Ranthalion/rfidLock/README.rst

rfidLock
--------
RFID Lock system

Lamp Server
-----------
Primary Network IP: 10.200.200.11 up on eth0   
Secure Network IP: 172.12.123.20 up on eth1   
Software: Apache2, php5 w/all mods, mariaDB, phpMyAdmin   
Services: SSHD   

Diagram
-------
