Ranthalion/rfidLock/esp8266/control/esp8266RFIDcontrol.kicad_pcb

## KiCad design esp8266/control/esp8266RFIDcontrol.kicad_pcb (2018-11-22)

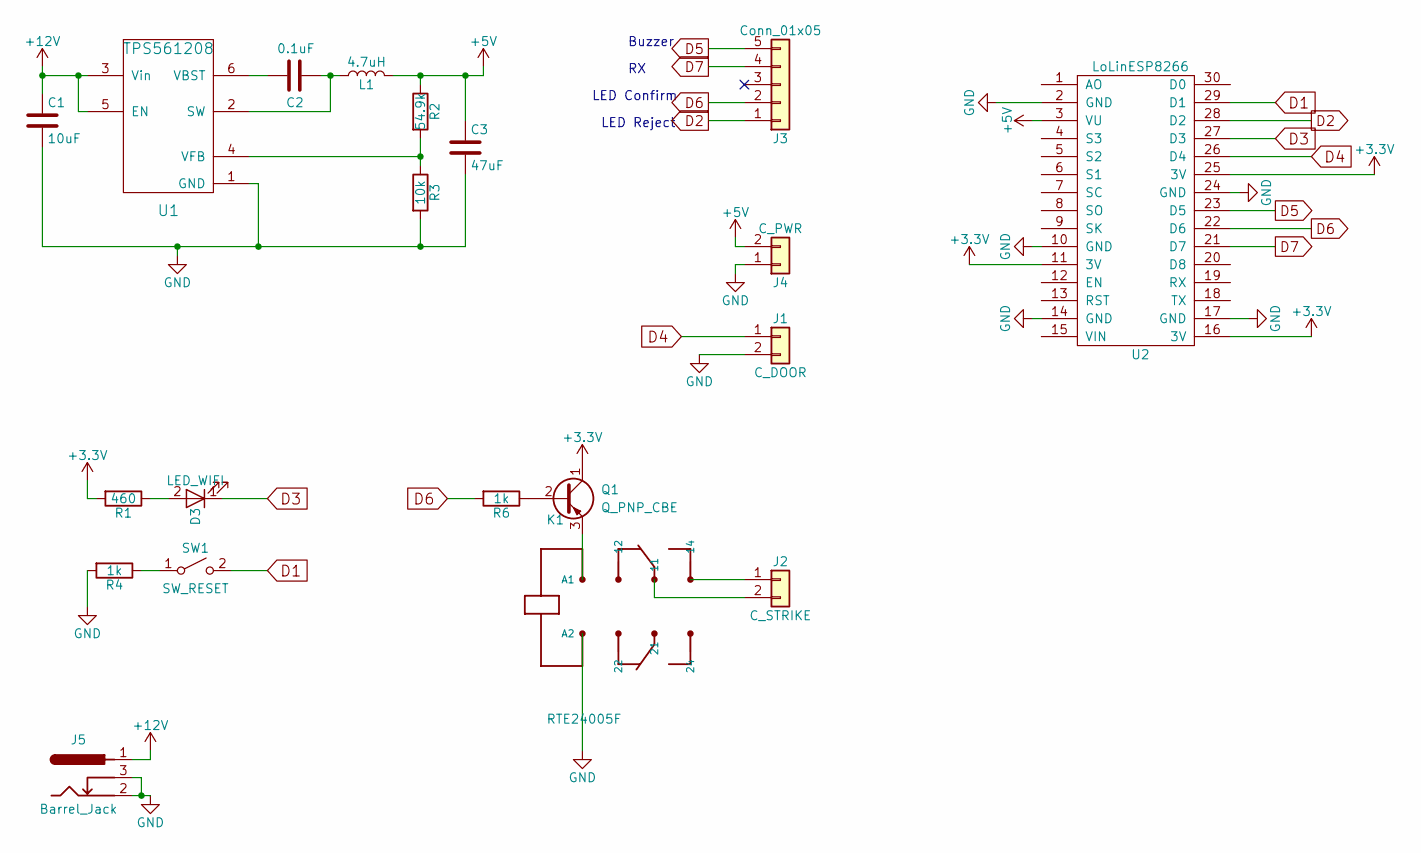
[picture p2: schematic esp8266RFIDcontrol.sch]

Parts:
C1: 10uF; C_1210_HandSoldering
C2: 0.1uF; C_1206_HandSoldering
C3: 47uF; C_1210_HandSoldering
D3: LED_WIFI; LED_0603_HandSoldering
J1: C_DOOR; CONNECTOR_JST_SH_2
J2: C_STRIKE; TerminalBlock_bornier-2_P5.08mm
J3: Conn_01x05; CONNECTOR_JST_SH_5
J4: C_PWR; CONNECTOR_JST_SH_2
J5: Barrel_Jack; BARREL_JACK
K1: RTE24005F
L1: 4.7uH; L_Wuerth_HCI-5040
Q1: Q_PNP_CBE; SOT-23_Handsoldering
R1: 460; R_0805_HandSoldering
R2: 54.9k; R_0805_HandSoldering; Tolerance 1%
R3: 10k; R_0805_HandSoldering; Tolerance 1%
R4, R6: 1k; R_0805_HandSoldering
SW1: SW_RESET; button_smd_2_pin
U1: TPS561208; SOT-23-6_Handsoldering
U2: LoLinESP8266; LOLIN_NODEMCU

Connections:
+3V3: Q1.1 (C), R1.2, U2.11 (3V), U2.16 (3V), U2.25 (3V)
+5V: C3.1, J4.2, L1.2, R2.1, U2.3 (VU)
+12V: C1.1, J5.1, U1.3 (Vin), U1.5 (EN)
D1: SW1.2 (B), U2.29 (D1)
D2: J3.1, U2.28 (D2)
D3: D3.1 (K), U2.27 (D3)
D4: J1.1, U2.26 (D4)
D5: J3.5, U2.23 (D5)
D6: J3.2, R6.2, U2.22 (D6)
D7: J3.4, U2.21 (D7)
GND: C1.2, C3.2, J1.2, J4.1, J5.2, J5.3, K1.A2, R3.2, R4.2, U1.1 (GND), U2.2 (GND), U2.10 (GND), U2.14 (GND), U2.17 (GND), U2.24 (GND)
unnamed: C2.1, L1.1, U1.2 (SW)
unnamed: C2.2, U1.6 (VBST)
unnamed: D3.2 (A), R1.1
unnamed: J2.1, K1.14
unnamed: J2.2, K1.11
unnamed: K1.A1, Q1.3 (E)
unnamed: Q1.2 (B), R6.1
unnamed: R2.2, R3.1, U1.4 (VFB)
unnamed: R4.1, SW1.1 (A)

Notes on the sheet:
Buzzer
LED Confirm
LED Reject

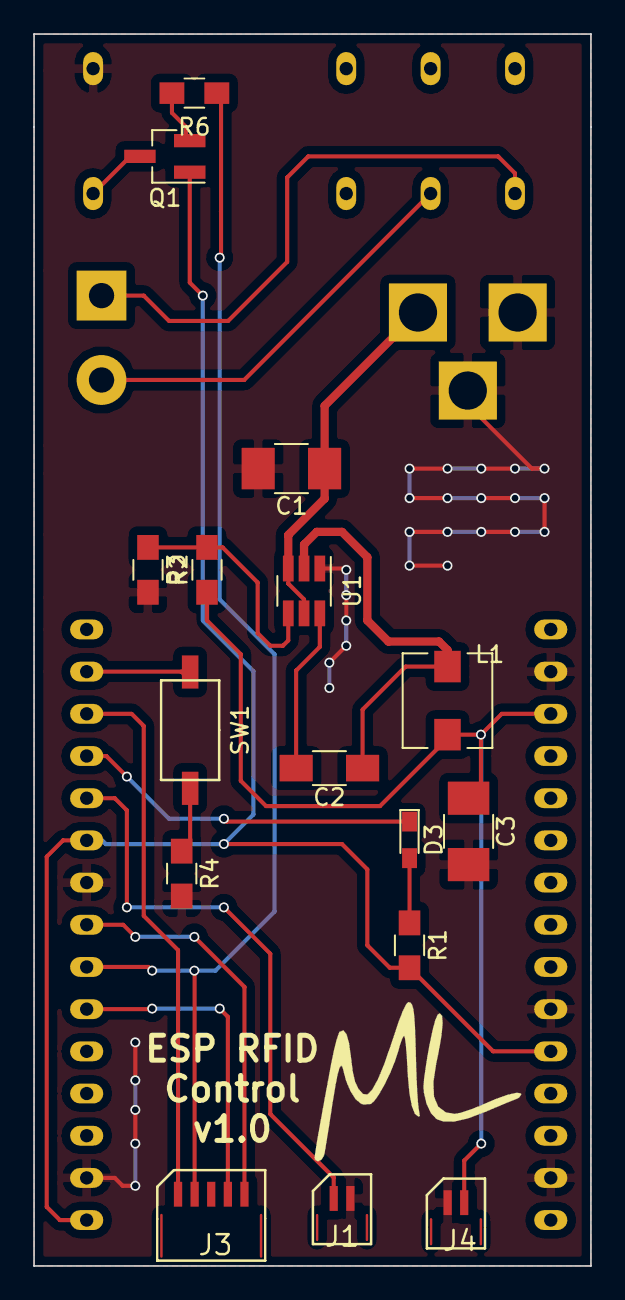
[picture p3: board esp8266RFIDcontrol.kicad_pcb from above]

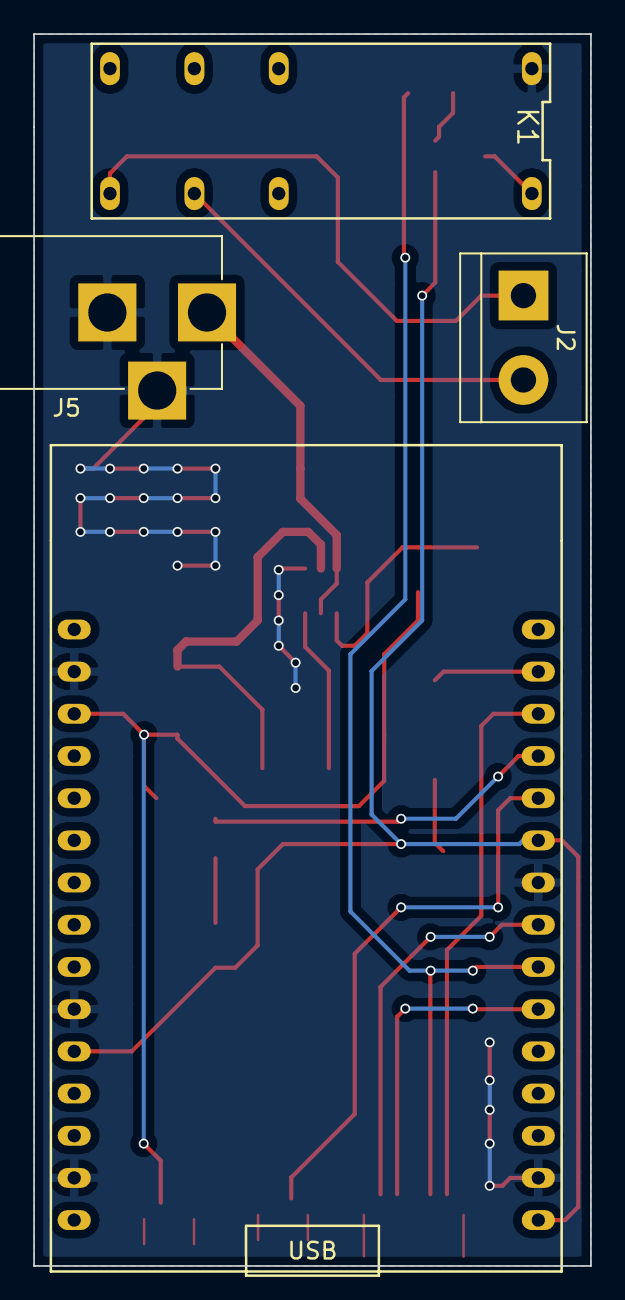
[picture p4: board esp8266RFIDcontrol.kicad_pcb from below]

Board: 2 copper layers, 33.5 x 74.2 mm, 20 parts (4 on the bottom side), 20 nets.
