Ranthalion/rfidLock/esp8266/reader/esp8266RFIDReader.kicad_pcb

## KiCad design esp8266/reader/esp8266RFIDReader.kicad_pcb (2018-06-21)

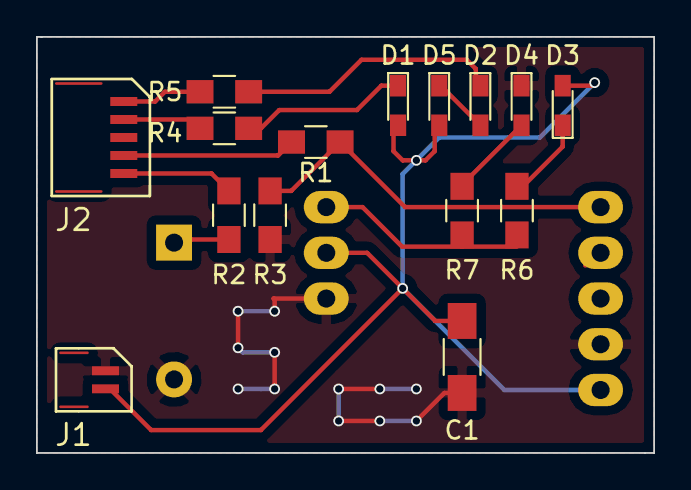
[picture p5: board esp8266RFIDReader.kicad_pcb from above]

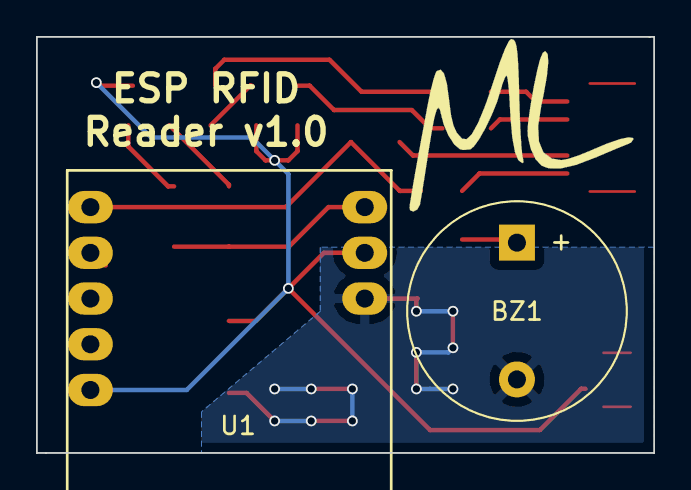
[picture p6: board esp8266RFIDReader.kicad_pcb from below]

Board: 2 copper layers, 34.3 x 23.1 mm, 17 parts (2 on the bottom side), 14 nets.

Parts:
BZ1: Buzzer; Buzzer_12x9.5RM7.6
C1: 0.1uF; C_1206_HandSoldering
D1: G; LED_0603_HandSoldering
D2, D5: R; LED_0603_HandSoldering
D3: B; LED_0603_HandSoldering
D4: Y; LED_0603_HandSoldering
J1: J1; CONNECTOR_JST_SH_2
J2: J2; CONNECTOR_JST_SH_5
R1: 10k; R_0805_HandSoldering
R2, R4, R5, R6, R7: 1k; R_0805_HandSoldering
R3: 20k; R_0805_HandSoldering
U1: RFID_MODULE_125_KHZ

Connections:
+5V: C1.1, D1.2, D3.2, D5.2, J1.2, U1.P1.5, U1.P3.2
Buzzer: J2.5, R2.2
GND: BZ1.2, C1.2, D4.1, J1.1, R3.1, U1.P1.4, U1.P3.3
LED_CONFIRM: J2.2, R4.2
LED_REJECT: J2.1, R5.2
unnamed: BZ1.1, R2.1
unnamed: D1.1, R4.1
unnamed: D2.1, R5.1
unnamed: D2.2, D5.1
unnamed: D3.1, R6.1
unnamed: D4.2, R7.1
unnamed: J2.4, R1.2
unnamed: R1.1, R3.2, U1.P1.1
unnamed: R6.2, R7.2, U1.P3.1
