Ranthalion/rfidLock/board/hackDoor.kicad_pcb

## KiCad design board/hackDoor.kicad_pcb (2017-01-17)

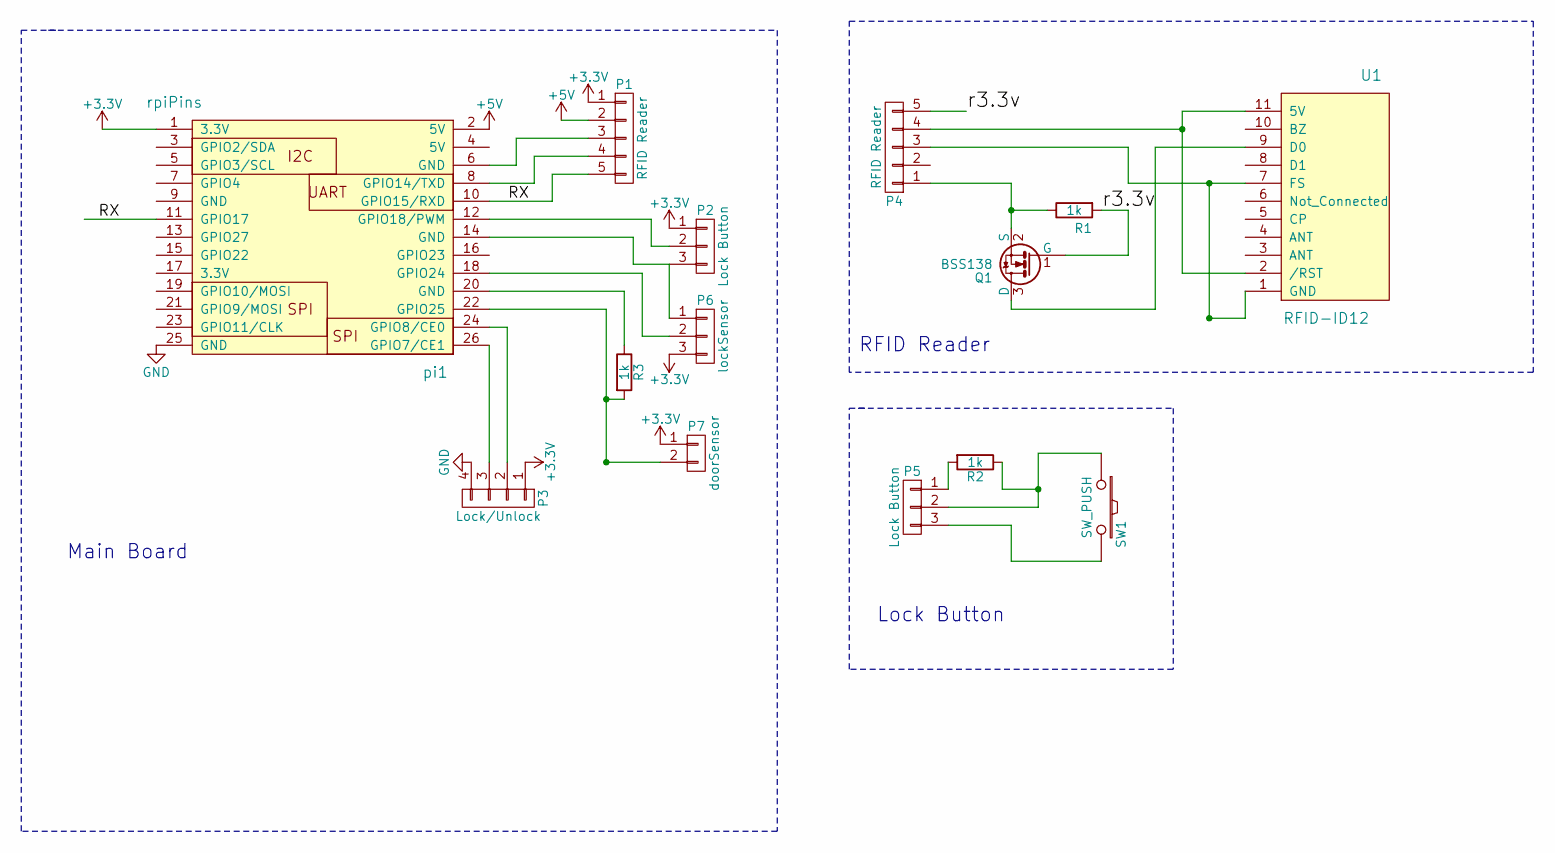
[picture p7: schematic hackDoor.sch]

Parts:
P1, P4: RFID Reader; Pin_Header_Angled_1x05
P2, P5: Lock Button; Pin_Header_Angled_1x03
P3: Lock/Unlock; Pin_Header_Angled_1x04
P6: lockSensor; Pin_Header_Angled_1x03
P7: doorSensor; Pin_Header_Angled_1x02
Q1: BSS138; SOT-23
R1, R2, R3: 1k; R_0805_HandSoldering
SW1: SW_PUSH
U1: RFID-ID12; rfid-id12
pi1: rpiPins; Pin_Header_Straight_2x13

Connections:
+3V3: P1.1, P2.1, P3.1, P6.3, P7.1, pi1.1 (3.3V)
+5V: P1.2, pi1.2 (5V)
/RX: P1.5, pi1.10 (GPIO15/RXD), pi1.11 (GPIO17)
/r3.3v: P4.5, Q1.1 (G), R1.2
GND: P3.4, pi1.25 (GND)
unnamed: P1.3, pi1.6 (GND)
unnamed: P1.4, pi1.8 (GPIO14/TXD)
unnamed: P2.2, pi1.12 (GPIO18/PWM)
unnamed: P2.3, P6.1, pi1.14 (GND)
unnamed: P3.2, pi1.24 (GPIO8/CE0)
unnamed: P3.3, pi1.26 (GPIO7/CE1)
unnamed: P4.1, Q1.2 (S), R1.1
unnamed: P4.3, U1.1 (GND), U1.7 (FS)
unnamed: P4.4, U1.2 (/RST), U1.11 (5V)
unnamed: P5.1, R2.2
unnamed: P5.2, R2.1, SW1.1
unnamed: P5.3, SW1.2
unnamed: P6.2, pi1.18 (GPIO24)
unnamed: P7.2, R3.2, pi1.22 (GPIO25)
unnamed: Q1.3 (D), U1.9 (D0)
unnamed: R3.1, pi1.20 (GND)

Notes on the sheet:
Main Board
RFID Reader
Lock Button

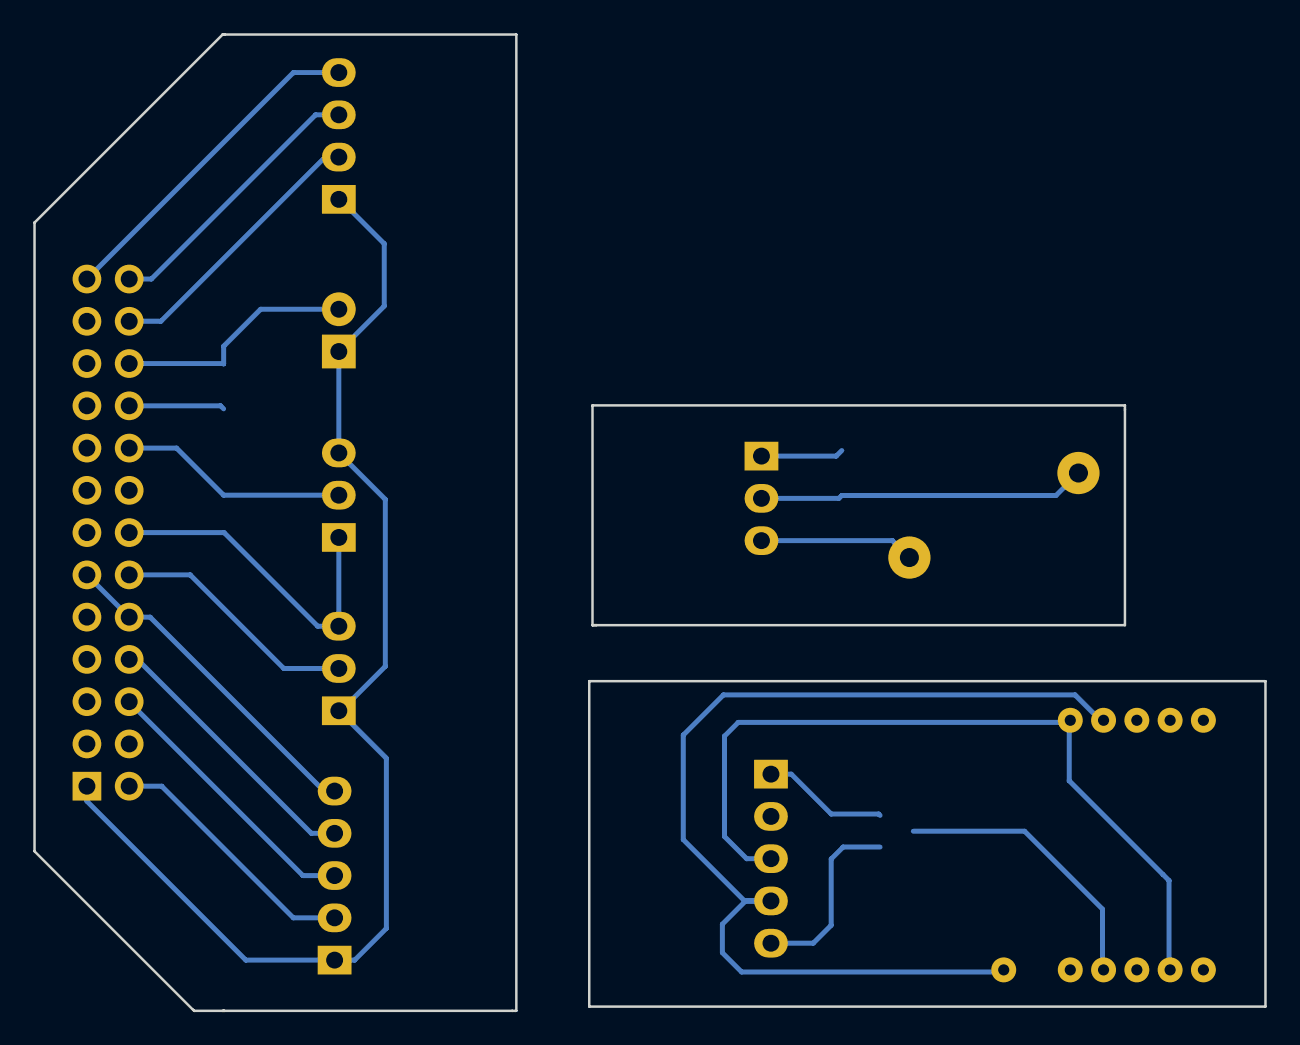
[picture p8: board hackDoor.kicad_pcb from above]

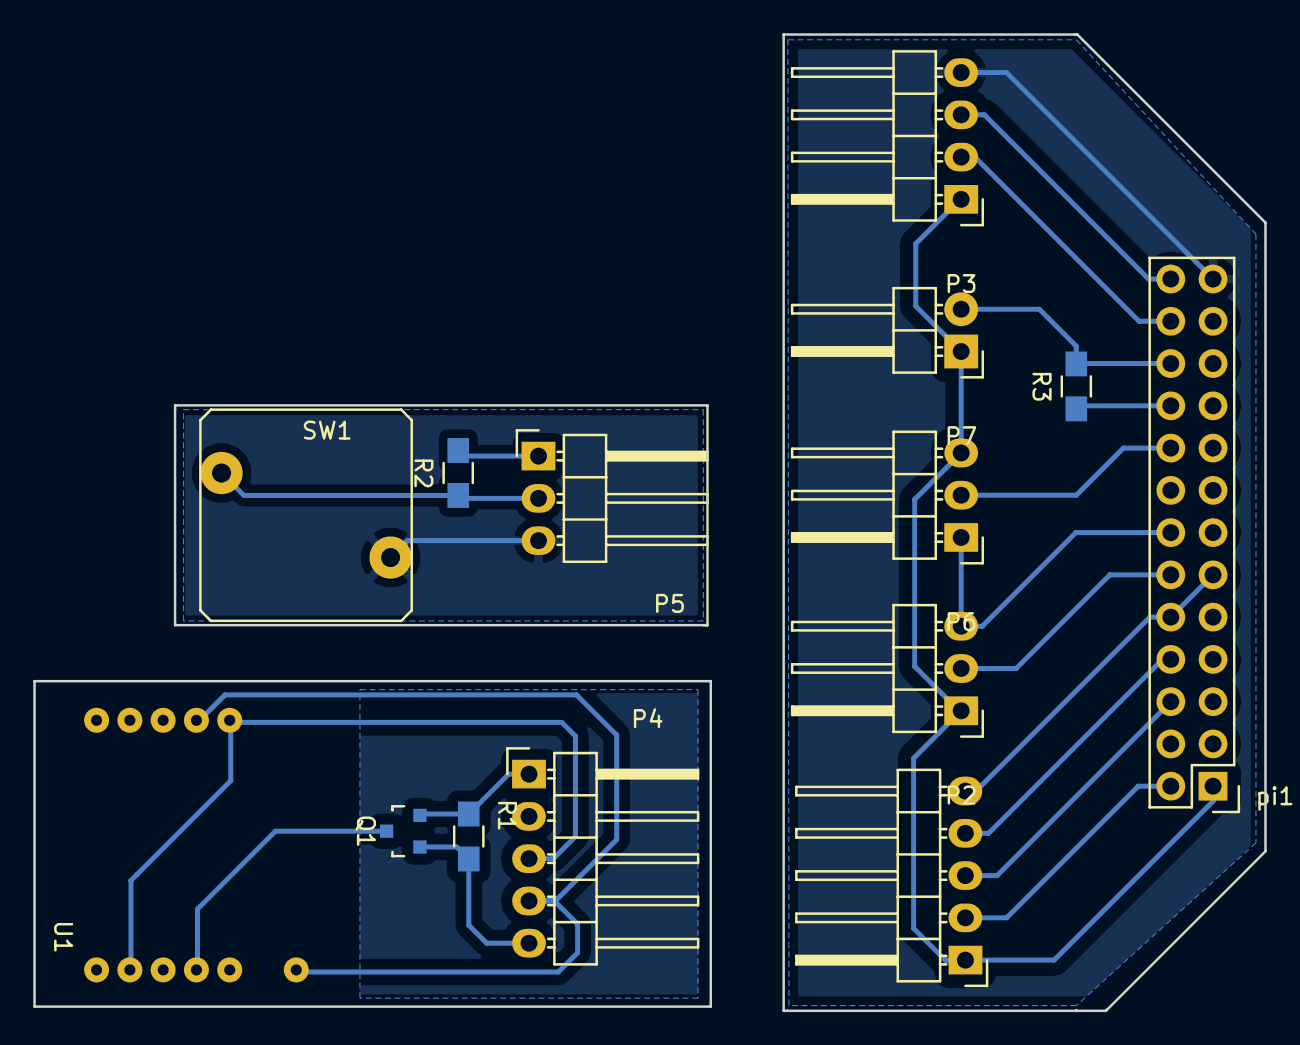
[picture p9: board hackDoor.kicad_pcb from below]

Board: 2 copper layers, 74.0 x 58.7 mm, 14 parts (14 on the bottom side), 21 nets.
