Ranthalion/rfidLock/(threads)

Thread 27 (2016-10-24):

Reinstate member

Ranthalion, 2016-10-24:
When a member has lapsed and comes in for a new key, the system will state that the member email address is already taken.   A new process should be created to for this use case.

Ranthalion, 2016-11-06:
The member should still have their key fob, so an automated process could take care of this scenario.  If the member had lost their key, the admin interface has a way to issue a new key to a member.

Thread 40 (2016-10-26):

Fix the door for reliable locking

Ranthalion, 2016-10-26:

Ranthalion, 2016-10-31:
Plate has been filed and should be sufficient.  Automatic door closer to be installed next week and should allow this issue to be closed.

Ranthalion, 2016-11-12:
Automatic closer installed.

Closed 2016-11-12.

Thread 48 (2016-10-31):

QB OAuth Renewal

Ranthalion, 2016-10-31:
Quickbooks uses OAuth and needs the tokens renewed every 6 months.  It is supported in the QBO API, but the keys are currently stored in .env.  Part of that will also need DB changes to support dynamically changing tokens.

Ranthalion, 2018-04-12:
I still don't want to do this and we're migrating members off of Quickbooks, so I'm closing this issue.

Closed 2018-04-12.

Thread 58 (2020-09-08):

Publicly accessible door status

Matt5sean3, 2020-09-08:
A long-standing frustration is that when the door is perceived to be not working there is no means by which a member may check the status of the door system. A status reporting system that members may consult to ensure the door system is still operating could be added to help relieve some of these frustrations.

Ranthalion, 2020-09-09:
Is this intended to be available outside of the hackRVA network?  Currently the web server is not visible unless you are on the hackRVA network.

Matt5sean3, 2020-09-09:
I can setup the appropriate HTTP configuration to make only the pages that we want to be public available externally.

Thread 69 (2020-09-30):

Job handler breaks occasionally

dfirebaugh, 2020-09-30:
Sometimes the job handler breaks and new members don't get slack invites.

I think the current (temp) fix is to restart the process
