Ranthalion/rfidLock/(commit log)

2016-09-25 added python code to: read rfids from the serial port check rfid against sqlite users database read button press for locking the door lock and unlock door
2016-09-30 adding kicad files
    [hackDoor.kicad_pcb, hackDoor.sch]
2016-10-02 added secondary schematics. added netlist and footprint association. started pcb layout.
    [hackDoor.kicad_pcb, hackDoor.sch]
2016-10-27 Stripped out superfluous portions of Python code and switched from revokation to expiration
2016-10-28 finished preliminary board routing. added rfid reader footprint
    [hackDoor.sch]
2016-10-28 some routing changes for the board
    [hackDoor.kicad_pcb]
2016-10-29 changed trace width to .30 mm
    [hackDoor.kicad_pcb]
2016-10-29 adding fabrication outputs
    [hackDoor.kicad_pcb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]
2016-11-05 removed copper pour from under rfid module. detached copper pour on rfid reader board from ground net
    [hackDoor.kicad_pcb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]
2016-11-05 routing change
    [hackDoor.kicad_pcb]
2016-11-11 added door and lock sensors. fixed the logic converter circuit on the rfid board
    [hackDoor.kicad_pcb, hackDoor.sch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]
2016-11-21 Update case for listeners
2016-12-24 added mirrored fab outputs and increased pad diameter on rfid module
    [hackDoor.kicad_pcb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]
2017-01-01 using the parameters for start_tx_pin and lock_button_pin in the Door class init. changing the raspberryPi template to reflect the pin mapping on the board
2017-01-17 Add logging, resize portion of tag read, and correct expiration_date to expire_date
    [Door.py]
2017-01-19 Switched RFID string for better consistency
2017-10-17 Initial ESP8266 device firmware for lock
2018-06-10 ESP8266 RFID reader sketch
    Updated sketch for ESP8266 based rfid reader. Added buzzer, indicator lights, and relay control.
    [ESP8266-RFID.ino]
2018-06-16 Schematic and PCB for RFID reader module + WIP for ESP board/module
    [esp8266RFID.kicad_pcb, esp8266RFID.sch, esp8266RFIDReader.kicad_pcb, esp8266RFIDReader.sch]
2018-06-21 Schematic and PCB for RFID control module.
    [_saved_esp8266RFIDcontrol.sch, esp8266RFID.kicad_pcb, esp8266RFID.sch, esp8266RFIDReader.kicad_pcb, esp8266RFIDReader.sch, esp8266RFIDcontrol.kicad_pcb, esp8266RFIDcontrol.sch]
2018-11-22 ESP8266 RFID reader board
    [_saved_esp8266RFIDcontrol.sch, esp8266RFIDReader.csv, esp8266RFIDReadernew.csv, esp8266RFIDcontrol.csv, esp8266RFIDcontrol.kicad_pcb, esp8266RFIDcontrol.sch, esp8266RFIDcontrolnew.csv]
2020-09-16 push to resource - an access list will now push to a resource when a network address is configured for that resource. - added doorDummy to help with testing - setting up events and listeners for heal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
